Alexislilei/matter-thermostat/docs/01_requirements.md

注意：
本文中出现的一对[COMMENT]之间的文字均不需要生成代码，属于作者的注释说明内容。
例子：
[COMMENT]
这是注释
这段内容只是给开发人员的提示信息，不属于需求内容
[/COMMENT]

# ESP32-C6 Matter 温控器需求规格说明书 (v0.3)

## 1. 项目概述
本项目基于 ESP32-C6 单芯片方案实现一款标准的 Wi-Fi + Matter 温控器设备。本设备支持本地独立运行与控制，无需依赖网络即可完成基础温控功能；同时作为标准 Matter 设备，可无缝接入 Home Assistant (HAOS)、Apple Home、Google Home 等智能家居生态系统，将定时开关机、复杂联动等高级功能交由上位系统处理。

---

## 2. 硬件资源配置与引脚分配

| 硬件模块 | 型号/类型 | 连接引脚 (GPIO) | 描述 / 说明 |
| :--- | :--- | :--- | :--- |
| **主控芯片** | ESP32-C6-DEVKITC-1 | - | 板载 Wi-Fi 6 + IEEE 802.15.4 (Matter) |
| **电源/配网按键** | 轻触开关 | GPIO19 | 按下 < 1s 待机/开机；按住 > 5s 进入配对模式；按住 > 15s 恢复出厂设置 |
| **旋转编码器 A 相** | EC11 (旋钮) | GPIO21 | 命名为 `KEY_RA`；板载 10k 上拉，C 脚接地。顺时针旋转：设定温度加/菜单切换 |
| **旋转编码器 B 相** | EC11 (旋钮) | GPIO20 | 命名为 `KEY_RB`；板载 10k 上拉，C 脚接地。逆时针旋转：设定温度减/菜单切换 |
| **编码器附加按键** | EC11 (按键) | GPIO15 | 命名为 `FUNC`；一端接地，另端板载 10k 上拉。用于页面切换/确定 |
| **睡眠定时按键** | 轻触开关 | GPIO18 | 命名为 `SLEEP`；一端接地，另端板载 10k 上拉。用于启动/关闭 Sleep Timer |
| **加热器控制** | Relay / Driver | GPIO22 | 高电平：开启加热；低电平：关闭加热 |
| **温度传感器** | DHT11 | GPIO4 | 单总线数字温湿度传感器（采用去抖/滤波算法） |
| **指示灯阵列** | WS2812B RGB LED | GPIO8 | 6 颗级联 RGB LED（LED_1 至 LED_6 串联） |
| **LCD 时钟 (共用)** | SPI SCK | GPIO12 | LCD 与触摸屏共用 SCK；**无外部上拉，需配置 GPIO 内部上拉** |
| **LCD 主出 (共用)** | SPI MOSI / T_DIN | GPIO11 | LCD 数据输入与触摸屏数据输入共用 MOSI；**无外部上拉，需配置 GPIO 内部上拉** |
| **LCD 主入 (共用)** | SPI MISO / T_DO | GPIO10 | 触摸屏数据返回至 ESP32；**无外部上拉，需配置 GPIO 内部上拉** |
| **LCD 片选** | LCD CS | GPIO2 | LCD 专属片选；**无外部上拉，需配置 GPIO 内部上拉** |
| **LCD 命令/数据** | LCD DC | GPIO3 | 高电平数据，低电平命令；**无外部上拉，需配置 GPIO 内部上拉** |
| **LCD 复位** | LCD RESET | GPIO1 | 硬件控制复位；**无外部上拉，需配置 GPIO 内部上拉** |
| **LCD 背光** | LCD LED | GPIO0 | 可用 PWM 调光，或接 3.3V 常亮；**无外部上拉，需配置 GPIO 内部上拉并置高** |
| **触摸屏片选** | Touch CS | GPIO13 | 触摸芯片 XPT2046 专属片选；**无外部上拉，需配置 GPIO 内部上拉** |
| **触摸屏中断** | Touch IRQ | GPIO23 | 触摸中断线（用于唤醒/触控响应）；**无外部上拉，需配置 GPIO 内部上拉** |

> **[COMMENT] 硬件上拉说明（重要）**
> 除按键/编码器（GPIO15/18/19/20/21）外，**所有 TFT-LCD 与触摸屏相关 GPIO（GPIO0/1/2/3/10/11/12/13/23）在硬件上均未连接外部上拉电阻**。
> 因此软件初始化时必须为这些引脚配置 **GPIO 内部上拉**（`GPIO_PULLUP_ENABLE`）：
> * 控制类引脚（背光 GPIO0、复位 GPIO1、片选 GPIO2、命令/数据 GPIO3）：配置为输出模式 + 内部上拉，并置为有效电平。
> * SPI 数据引脚（SCK GPIO12、MOSI GPIO11、MISO GPIO10）与触摸引脚（CS GPIO13、IRQ GPIO23）：配置为输入模式 + 内部上拉。
> 该配置已在 `main/main.c` 的 `app_main()` 中实现。
> [/COMMENT]

---

## 3. 智能设备与网络功能 (Wi-Fi / Matter)

### 3.1 协议支持
本项目设备为标准的 Wi-Fi + Matter 温控器（Matter Thermostat）设备。
设备的温度检测值、设定温度值、加热状态及开关状态需同步暴露至 Matter 协议簇（Clusters）。

### 3.2 配网逻辑与模式 (Commissioning Modes)
* **首次上电自动配网 (First Power-on Commissioning)**：
  未绑定网络的设备在首次上电或恢复出厂设置后，自动进入 Matter 配网广播状态（广播 BLE / Wi-Fi 配网信息）。
  * **超时机制**：配网模式开启后生效时间为 15 分钟。若 15 分钟内未完成配网，设备自动关闭配网广播并退出配网模式，恢复为本地独立运行状态，以节省系统资源与保证安全。
* **手动触发配网 (Manual Pairing Trigger)**：
  在任何工作状态下，长按电源键 (GPIO19) 保持 5 秒，设备强制重置配网状态并启动一个新的 15 分钟 Matter 配网广播窗口。
* **配网状态与结果指示**：
  * **配网进行中**：LED_1 显示黄色呼吸灯，呼吸周期为 2 秒。
  * **配网成功**：LED_1 快闪两下绿色（亮 200ms / 灭 200ms），随后进入下一个工作状态（开机或待机模式）。
  * **配网失败 / 超时**：LED_1 快闪两下红色（亮 200ms / 灭 200ms），随后退出配网模式进入下一个状态。

### 3.3 配网凭证与载体 (Commissioning Credentials)
* **配网二维码 (QR Code)**：设备外壳及产品包装上须印制符合 Matter 规范的二维码（内含 Vendor ID, Product ID, Discriminator, Passcode 等信息），用于控制端 App 扫码配网。
* **手动配网码 (Manual Pairing Code)**：二维码下方须清晰印制 11 位或 21 位数字手动配网码，作为二维码破损时的备用输入方案。

### 3.4 多生态共享绑定 (Multi-Admin Feature)
设备必须完整支持 Matter 标准的 **Multi-Admin（多主控绑定）** 特性。
设备在绑定至首个生态（如 Apple Home）后，无需重置设备，即可在现有主控 App 中开启“共享/添加设备”模式，动态生成一个新的临时配网码，将其绑定至第二生态（如 Google Home、Home Assistant 等）。

### 3.5 恢复出厂与解绑 (Factory Reset & De-commissioning)
* **硬件重置**：按住 POWER (GPIO19) 按键大于 15 秒，设备触发恢复出厂设置逻辑，清空设备内存储的所有 Matter 节点凭证、Wi-Fi 网络配置及生态绑定关系。在恢复出厂操作结束后，LED_1 快闪两下白色（亮 200ms / 灭 200ms），随后 LED_2 ~ LED_6 依次逐个快闪一下（亮 200ms / 灭 200ms），最后自动重启并重新进入首次上电配网模式。
* **软件解绑**：当用户从已绑定的 Matter 控制端 App 中执行“移除设备”时，设备若接收到撤销指令，需清除对应的网络节点凭证；在成功解除绑定后，LED_1 快闪一下橙色（亮 200ms / 灭 200ms），紧接着快闪一下绿色（亮 200ms / 灭 200ms），随后进入下一个状态。当最后一个绑定节点被移除时，设备自动恢复出厂待配网状态。
* **状态复位**：重置或解绑清空凭证后，设备自动重启并进入 **首次上电配网模式**。

---

## 4. 按键与编码器检测与操作逻辑

### 4.1 通用检测算法
* 所有按键与编码器检测必须加入软件去抖动算法，消除机械与电气抖动干扰。
* 支持按键短按与长按事件检测，以及编码器的正反转相位判断（根据 `KEY_RA` 与 `KEY_RB` 的引脚电平变化次序）。

### 4.2 按键与旋转操作定义
* **电源键 POWER (GPIO19)**：
  * 按下小于 1 秒：待机 / 开机切换。
  * 按住大于 5 秒：进入配对模式（手动触发 Matter 重新配网，开启 15 分钟配网窗口）。
  * 按住大于 15 秒：恢复出厂设置（清空所有网络与配网信息，按 3.5 节规则展示灯效并重新进入配网广播模式）。
* **编码器旋转 (KEY_RA: GPIO21 / KEY_RB: GPIO20)**：
  * **主页面下**：顺时针旋转，设定温度增加 0.5℃（上限 25.0℃）；逆时针旋转，设定温度减少 0.5℃（下限 15.0℃）。
  * **Sleep Timer 设置页面下**：旋转编码器用于在睡眠时间选项之间切换选择（10 MIN -> 30 MIN -> 60 MIN -> 90 MIN，两端停住不循环）。
* **编码器附加按键 FUNC (GPIO15)**：
  * **页面切换**：按一下 FUNC 键依次循环切换页面（主页面 -> Sleep Timer 设置页面 -> 主页面）。
* **睡眠定时按键 SLEEP (GPIO18)**：
  * **定时开关**：按一下 SLEEP 键启动/关闭 Sleep Timer 倒计时（等同于点击屏上右下角的触摸按键）。
* **待机唤醒与自动超时**：
  * 在待机模式下，按下 POWER 按键小于 1 秒、短按 FUNC 按键、短按 SLEEP 按键或旋转编码器，设备立即恢复至开机模式。
  * **超时返回**：在非主页面（如 Sleep Timer 设置页）下，若持续 1 分钟（60 秒）无任何操作，系统自动保存当前设置并重置返回主页面显示。

---

## 5. UI 界面与显示需求 (ILI9341 LCD)

### 5.1 硬件与库配置
* **屏幕规格**：2.4 英寸 ILI9341 TFT LCD，分辨率 320 * 240，竖屏显示（宽 240，高 320）。
* **触控芯片**：XPT2046（通过 GPIO23 IRQ 中断进行事件响应/唤醒）。
* **图形驱动**：用 ESP-IDF 原生的 esp_lcd 组件（IDF 5.1 自带），通过 SPI 驱动 ILI9341，并使用 LVGL 作为 UI 渲染层（ESP32 官方推荐方案，性能与 TFT_eSPI 相当）。
* **LVGL 接入**：通过 `espressif/esp_lvgl_port` 组件（版本 `^1.4.0`，内部使用 LVGL 8.3）完成 esp_lcd 与 LVGL 的桥接，在 `main/idf_component.yml` 中声明依赖。
* **界面文字风格**：优先采用通用图标、图形符以及极简英文/英文缩写，兼顾直观性与系统稳定性。

### 5.2 页面结构与布局定义

```
+---------------------------------------------+  <-- Y = 0
| Fri, Mar 11  19:45                  (Wi-Fi) |  1. Top Bar (日期/时间/Wi-Fi, H: 26px)
+---------------------------------------------+
|                                             |
|                   ● (20°)                   |
|              .-------------..               |  2. Central Arc & Temp Area (Y: 28 ~ 250)
|            /     .--------.    \            |     - 270° 刻度环 (135° ~ 45°)
|    ●(17.5°)|   /   23°    \   |● (22.5°)   |     - 蓝色实心进度圆弧 (当前温度)
|            |  |  (当前室温) |  |   [22.5°]  |     - 黄色刻度线与外侧目标温度标签
|            \   \  ROOM    /   /   (目标指针)|     - 内部深色同心圆表盘
|    15° ●    `-------------`    ● 25°        |     - 表盘正中心大字整数室温 (如 23°)
|                                             |     - 底侧 15° 与 25° 极值标注
+---------------------------------------------+
|  +---------------+       +---------------+  |  3. Bottom Area (Y: 256 ~ 312)
|  |    HEATER     |       |  SLEEP TIMER  |  |     - 左侧: 加热状态卡片 (HEAT/OFF)
|  |  HEAT / OFF   |       |  OFF / 28:30  |  |     - 右侧: Sleep Timer 定时按钮
|  +---------------+       +---------------+  |
+---------------------------------------------+  <-- Y = 320
```

#### **页面 1：主页面 (Main Page)**
1. **第一行：顶部状态栏 (Top Bar)**
   * **布局**：单行紧凑排列。
   * **左侧**：显示当前日期与时间（缩写星期与月份，24 小时制，例如：`Fri, Mar 11  19:45`）。时间通过 SNTP 获取 UTC 并转换为 **澳大利亚东部标准时间（AEST/AEDT，自动夏令时）**。
   * **右侧**：显示 Wi-Fi 状态图标（`LV_SYMBOL_WIFI`）。已连接常亮；未连接时以 0.5s 周期闪烁提示。
2. **第二行：中央温度控制与显示区 (Central Arc & Temp Display)**
   * **温度范围**：**15.0°C 至 25.0°C**（共 21 个 0.5°C 档位）。
   * **中央当前温度**：显示在圆环正中央深色同心表盘中，大字体（48 号字），仅显示**整数**（例如：`23°`），下方配 `ROOM` 标签。
   * **当前温度蓝色圆弧与目标温度圆弧**：
     * 从 15°C 起始刻度（135°）开始顺时针绘制亮蓝色圆弧（`#00B4FF`），延伸至当前实测温度对应的角度。
     * **圆环尺寸**：外侧温度指示与调节圆弧半径设计为紧凑尺寸（外半径 84px，尺寸 168×168），与内部中央表盘（半径 63px，尺寸 126×126）之间保持约 11px 的清晰间隙，不与内圆接触，两侧留出充足屏幕边距。
   * **外圈刻度点与极值**：外圈半径 84px 处分布 5 个分度圆点（15.0°C, 17.5°C, 20.0°C, 22.5°C, 25.0°C），底部两侧分别标注 `15°` 与 `25°`。
   * **目标温度指示与显示**：
     * **黄色刻度线**：在圆环外圈以黄色滑块（`#FFD700`）指示当前设定的目标温度位置。
     * **目标温度数值**：在黄色刻度线外侧水平显示目标温度数值，支持 1 位小数精度（例如：`22.5°`），黄色文字。当设定为 20.0°C（270° 正上方）时，读数位置确保完全在顶部白底状态栏（Y=0~26）下方并留有安全间距，不侵入顶部白底。
   * **目标温度调节逻辑**：
     * **触摸调节**：支持通过触摸屏滑动黄色刻度线调节（自动吸附为 0.5°C 步长）。
     * **编码器调节**：支持旋转编码器输入。顺时针增加 0.5°C，逆时针减少 0.5°C，范围限制在 15.0°C ~ 25.0°C。
3. **第三行：底部状态与操作栏 (Bottom Area)**
   * **左侧 (加热状态)**：卡片式按钮显示 `HEATER`，状态显示 `HEAT`（加热中，红色高亮）或 `OFF`（未加热，灰白色）。
   * **右侧 (Sleep Timer 按钮)**：卡片式按钮显示 `SLEEP TIMER`，下半部分显示 `OFF` 或倒计时时间（`mm:ss` 格式，绿色高亮）。触摸点击该按钮可开启/关闭倒计时。倒计时结束后自动切换至待机模式。

#### **页面 2：定时睡眠设置页 (Sleep Timer Page)**
* **页面标题**：顶部显示 `SLEEP TIMER SETTING`，标题栏为蓝底黑字。标题栏紧贴顶部日期/时间栏下方（y=30），蓝色底不遮挡日期与时间。
* **选项列表**：提供 4 个选项，从上到下顺序为 `10 MIN` / `30 MIN` / `60 MIN` / `90 MIN`（已移除 `OFF` 选项）。
* **默认值**：第一次开机默认值为 `30 MIN`。
* **记忆功能**：改动后记忆该设定值，下次上电时从 NVS 读取记忆的设定值（命名空间 `sleep_timer`，键 `setting`）。
* **显示方式**：选中项始终显示在屏幕中间偏下位置（较屏幕正中整体下移 22px），选中项文本外有一个框，颜色为正常显示的反转（白底黑字）；未选中项为黑底白字（黑色背景 + 白色文字）。
* **编码器操作**：
  * 顺时针旋转编码器一格，整个选项列表向上移动一个位次（选中项向后移动），到最后一个选项（`90 MIN`）就停住，不做周期移动。
  * 逆时针旋转则反之，到第一个选项（`10 MIN`）停住。
  * 若向上移动后最上面的空间不够（不能阻挡页面标题），则最上面一个选项不显示；反之（超出屏幕底部）亦然。选中 `10 MIN` 时 `90 MIN` 选项仍会显示（其框底恰好贴屏幕底边 320）。
* **触发方式**：实体 FUNC 按键仅将主页面切换到本设置页（不启动倒计时）；仅屏上右下角的触摸按键触发 sleeper（睡眠定时）启动。
* **倒计时逻辑**：触摸按键确认选择后开始倒计时，页面回到主页面，倒计时结束后设备自动切入待机模式（软关机），GPIO22 关闭加热。

#### **页面 3：待机页 (Standby Page)**
* **页面布局与要素**：
  * **第一行（顶部）**：保持显示顶部状态栏（白底黑字，左侧显示日期/时间，右侧显示 Wi-Fi 图标）。
  * **第二行（中央偏上）**：以超大号字（与主页面一致，48 号字白色）显示实测当前室温（例如：`20°`）。
  * **第三行（中央偏下）**：以大号字（32 号字白色）显示 `STANDBY` 状态指示。
  * **控件隐藏**：待机模式下隐藏主页的温度调节圆弧、表盘刻度与底部加热/定时操作按钮，保持待机界面极简且清晰。

### 5.3 触摸屏校准需求 (Touch Calibration)

> **[COMMENT] 背景说明**
> 电阻式触摸屏（XPT2046）的原始 ADC 值范围与方向因硬件个体差异而不同，且屏幕坐标与 ADC 通道之间可能存在轴交换（swap_xy）与镜像（invert_x / invert_y）。为保证触摸坐标映射准确（例如 Timer 按钮点击位置正确），需在首次使用时进行一次校准，并将校准参数持久化存储，避免每次上电重复校准。
> [/COMMENT]

1. **首次开机自动校准 (First Power-on Calibration)**：
   * 设备**首次上电**（或校准参数缺失/无效）时，自动进入触摸校准流程，在 LCD 上显示校准页面。
   * 校准页面标题 `TOUCH CALIBRATION` 位于屏幕**中间偏上**位置（在中间提示文字上方，避免重叠）。
   * 校准页面依次提示用户点击屏幕 **4 个角点**：左上 (TL) → 右上 (TR) → 左下 (BL) → 右下 (BR)。
   * 每个角点显示一个圆形目标标记，用户按下后采样该点的原始 ADC 值，松开后进入下一个角点。
   * 4 个角点全部采样完成后，根据角点原始值自动计算校准参数：
     * 自动判定 X/Y 轴是否需要交换（`swap_xy`）。
     * 自动判定 X/Y 轴是否需要镜像（`invert_x` / `invert_y`）。
     * 计算各轴的最小/最大值（`x_min` / `x_max` / `y_min` / `y_max`），用于将原始 ADC 值线性映射为屏幕像素坐标（240×320）。
   * 若某角点采样无效（如轴范围过小 < 50），判定为无效采样，重新等待该角点输入。
2. **校准参数持久化存储 (Persistence)**：
   * 校准完成后，将校准参数（`touch_calibration_t`）与"已校准"标记写入 **NVS**（命名空间 `touch_calib`，键 `calib` 与 `calibrated`）。
   * 校准参数在设备重启后仍然保留。
3. **后续上电跳过校准 (Skip on Subsequent Power-on)**：
   * 每次上电时检查 NVS 中的"已校准"标记：
     * 若标记存在（已校准）：直接加载校准参数，**跳过**校准流程，进入正常主界面。
     * 若标记不存在（未校准）：执行首次校准流程。
4. **校准期间交互隔离**：
   * 校准流程进行期间，触摸轮询任务（`touch_poll_task`）暂停处理 Timer 按钮等正常触摸交互，避免校准触摸被误判为按钮点击。
   * 校准页面激活期间，正常 UI 渲染（`ui_render`）暂停更新，避免覆盖校准页面。
   * 校准页面激活期间，隐藏所有非校准相关内容（日期时间、Wi-Fi 符号、室温、设定温度、加热状态、Timer 按钮、待机文字、Sleep Timer 标题与选项等），仅显示校准页面内容；校准结束后恢复普通 UI。

---

## 6. 指示灯阵列与灯效设计

### 6.1 硬件阵列分工与映射
* **LED_1**：温控器状态/配网指示灯。
* **LED_2 ~ LED_6**：当前温度与目标设定温度指示灯。
  * **LED_2**：<= 17 ℃
  * **LED_3**：18 ℃
  * **LED_4**：19 ℃
  * **LED_5**：20 ℃
  * **LED_6**：>= 21 ℃

### 6.2 灯效展示规则
1. **快闪定义 (Fast Blink)**
   * 文中所述的 “快闪” 均指：亮 200ms，灭 200ms 的闪烁周期。
2. **上电自检 (POST)**
   * 上电后，LED_1 至 LED_6 依次点亮 100ms 白色后熄灭，随后进入待机模式（若未配网则进入配网模式）。
3. **配网及网络状态灯效**
   * **配网进行中**：LED_1 显示黄色呼吸灯，呼吸周期为 2 秒。
   * **配网成功**：LED_1 快闪两下绿色（亮 200ms / 灭 200ms），再进入下一个状态（开机/待机）。
   * **配网失败 / 超时**：LED_1 快闪两下红色（亮 200ms / 灭 200ms），再进入下一个状态。
   * **解除绑定**：成功解绑后，LED_1 快闪一下橙色，再快闪一下绿色（各亮 200ms / 灭 200ms）。
   * **恢复出厂结束**：恢复出厂结束后，LED_1 快闪两下白色，随后 LED_2 ~ LED_6 依次逐个快闪一下（各亮 200ms / 灭 200ms）。
4. **开机模式灯效**
   * **所有LED灯亮度设定位50%**
   * **LED_1（加热/状态指示）**：
     * **加热中 (GPIO22 = HIGH)**：循环展示灯效——200ms 橙色 -> 200ms 红色 -> 200ms 紫色 -> 循环。
     * **未加热 (GPIO22 = LOW)**：常亮绿色。
   * **LED_2 ~ LED_6（温度指示）**：
     * 小于当前实测温度的指示灯：常亮绿色。
     * 大于当前实测温度且非设定温度的指示灯：熄灭。
     * 设定温度对应的指示灯：显示紫色。
     [COMMENT]
     这里的
       * 若实测温度 < 设定温度：显示紫色。
       * 若实测温度 >= 设定温度：交替显示绿色和紫色，各切换保持 1 秒。
       
     [/COMMENT]
    
5. **待机模式灯效**
   * **待机定义**：软待机（软关机）。内部主控、Matter 协议、Wi-Fi 及温度采集控制逻辑均正常运行，GPIO22 停止加热，LED_2 ~ LED_6 熄灭。
   * **LED_1（待机温度呼吸灯）**：根据当前 DHT11 实测温度，以 2 秒为周期进行呼吸显示，颜色映射关系如下：
     * <= 17 ℃：蓝色呼吸灯
     * 18 ℃：青色呼吸灯
     * 19 ℃：绿色呼吸灯
     * 20 ℃：黄色呼吸灯
     * 21 ℃：橙色呼吸灯
     * 22 ℃：红色呼吸灯
     * >= 23 ℃：紫色呼吸灯

---

## 7. 温控与采样算法

### 7.1 温度数据去抖与滤波
DHT11 数据采集需采用数字滤波/去抖动算法（如滑动平均滤波或中值滤波），避免突发噪声引发系统频繁误判及屏幕数字频繁跳动。

### 7.2 迟滞温控逻辑 (Hysteresis Control)
* **设定温度限制**：设定温度限制在 15.0 ℃ 至 25.0 ℃（步长 0.5 ℃）。
* **动态阈值调整**：为防止加热开关在临界点频繁启停，设置 ±0.5 ℃ 的控制滞后区间。
* **升温过程**：当加热器处于开启状态时，只有当实测温度上升至 `设定温度 + 0.5 ℃` 时，才关闭加热器 (GPIO22 = LOW)。
* **降温过程**：当加热器处于关闭状态时，只有当实测温度下降至 `设定温度 - 0.5 ℃` 时，才重新开启加热器 (GPIO22 = HIGH)。
