Alexislilei/matter-thermostat/docs/others/TFT LCD 2.8 inch ILI9341 touch.step

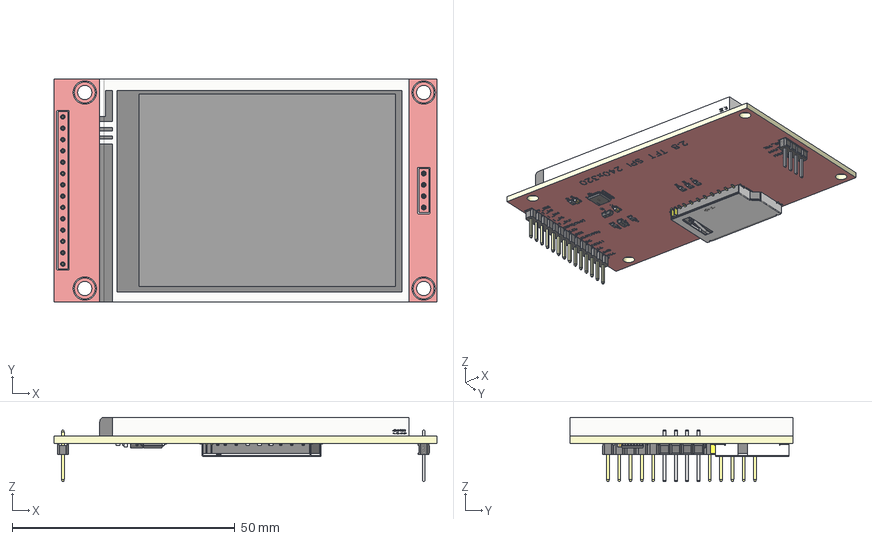
[picture p1: CAD file, 2026-07-20, last stored version]
docs/others/TFT LCD 2.8 inch ILI9341 touch.step
86.0 x 50.0 x 14.5 mm
Board~s9RP
TopSilkscreen~s9RP
BottomSilkscreen~s9RP
HDR-TH_4P-P2.54-V-M~HDR-TH_4P-P2.54-M-LI-1X4P~s9RP
R0603~R0603~s9RP x 6
C0603~C0603_L1.6-W0.8-H0.8~s9RP x 2
CONN-TH_PZ254V-11-14P~CONN-TH_PZ254V-11-14P~s9RP
SD-CARD-SMD_SD-CARD-11P~SD-CARD-SMD_SD-CARD-11P~s9RP
TSSOP-16_L5.0-W4.4-P0.65-LS6.4-BL~TSSOP-16_L5.0-W4.4-H1.0-LS6.4-P0.65 ~s9RP
SOT-23-3_L2.9-W1.3-P1.90-LS2.4-BR~SOT-23-3P_L2.9-W1.3-H1.0-LS2.4-P0.9 5~s9RP x 2
