Alexislilei/matter-thermostat/docs/tft-lcd-2-8-inch-ili9341-touch-320x240-1.snapshot.22/TFT LCD 2.8 inch ILI9341.stl

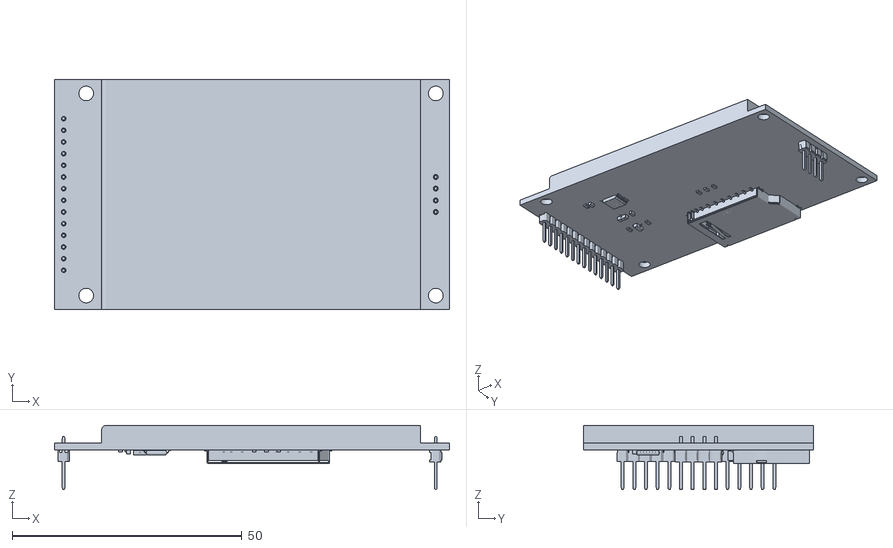
[picture p2: CAD file, 2026-07-19, last stored version]
docs/tft-lcd-2-8-inch-ili9341-touch-320x240-1.snapshot.22/TFT LCD 2.8 inch ILI9341.stl
86.0 x 50.0 x 14.0
