Alexislilei/matter-thermostat/docs/thermostat-hardware/thermostat-hardware.kicad_sch

## KiCad design docs/thermostat-hardware/thermostat-hardware.kicad_sch (2026-07-20, an earlier design)

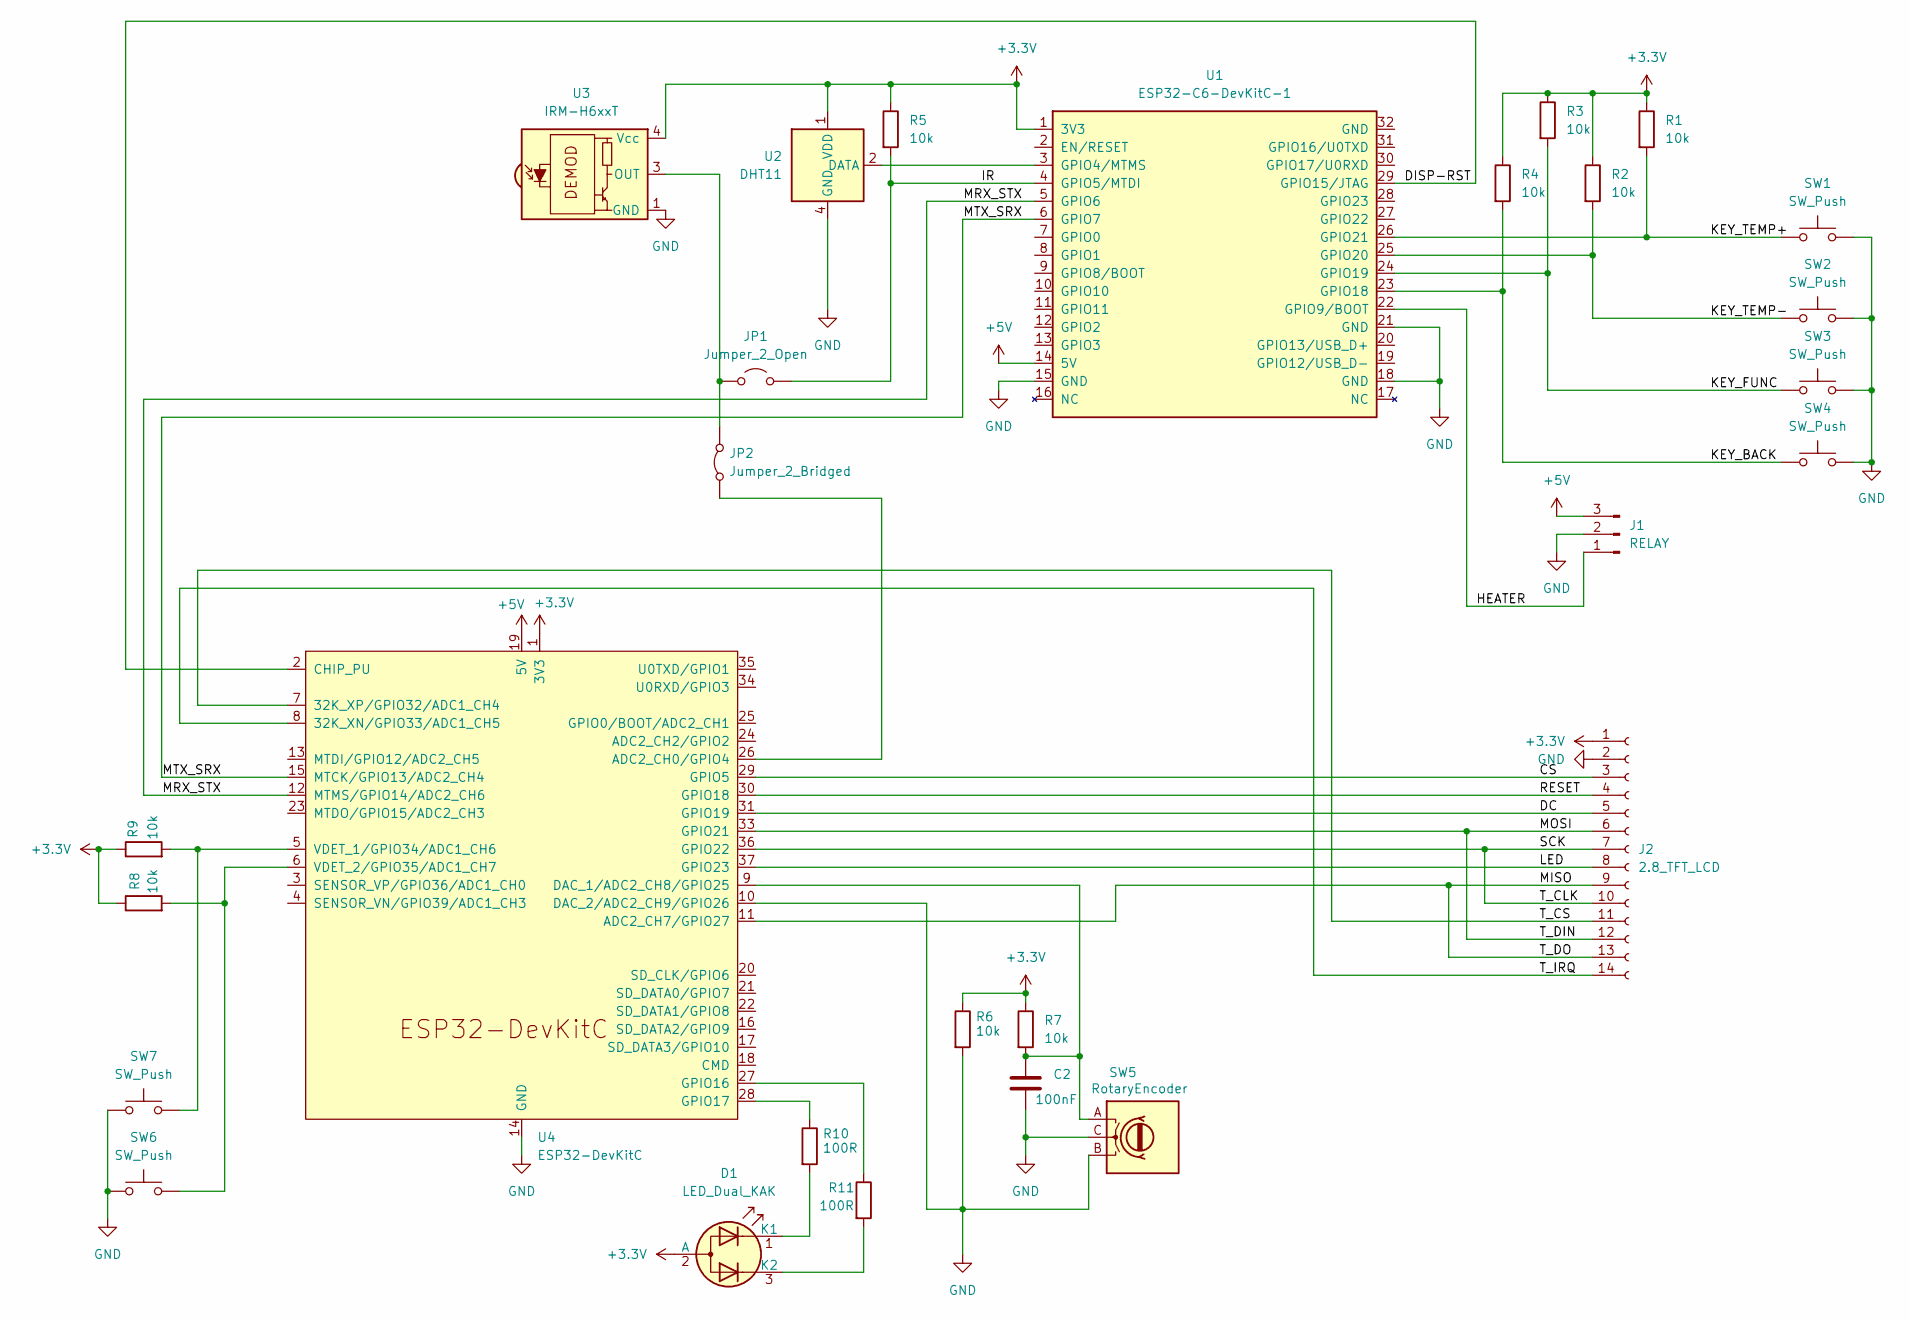
[picture p3: schematic thermostat-hardware.kicad_sch]

Parts:
C2: 100nF; C_Rect_L7.0mm_W2.0mm_P5.00mm
D1: LED_Dual_KAK
J1: RELAY
J2: 2.8_TFT_LCD
JP1: Jumper_2_Open
JP2: Jumper_2_Bridged
R1, R2, R3, R4, R5, R6, R7, R8, R9: 10k; R_Axial_DIN0207_L6.3mm_D2.5mm_P7.62mm_Horizontal
R10, R11: 100R; R_Axial_DIN0207_L6.3mm_D2.5mm_P7.62mm_Horizontal
SW1, SW2, SW3, SW4, SW6, SW7: SW_Push; SW_PUSH_6mm
SW5: RotaryEncoder
U1: ESP32-C6-DevKitC-1
U2: DHT11; Aosong_DHT11_5.5x12.0_P2.54mm
U3: IRM-H6xxT; Everlight_IRM-H6xxT
U4: ESP32-DevKitC

Connections:
+3.3V: D1.2 (A), J2.1, R1.1, R2.1, R3.1, R4.1, R5.1, R6.1, R7.1, R8.1, R9.1, U1.1 (3V3), U2.1 (VDD), U3.4 (Vcc), U4.1 (3V3)
+5V: J1.3, U1.14 (5V), U4.19 (5V)
CS: J2.3, U4.29 (GPIO5)
DC: J2.5, U4.31 (GPIO19)
DISP-RST: U1.29 (GPIO15/JTAG), U4.2 (CHIP_PU)
GND: C2.2, J1.2, J2.2, R6.2, SW1.2, SW2.2, SW3.2, SW4.2, SW5.B, SW5.C, SW6.1, SW7.1, U1.15 (GND), U1.18 (GND), U1.21 (GND), U2.4 (GND), U3.1 (GND), U3.2 (GND), U4.10 (DAC_2/ADC2_CH9/GPIO26), U4.14 (GND), U4.32 (GND), U4.38 (GND)
HEATER: J1.1, U1.22 (GPIO9/BOOT)
IR: JP1.2 (B), R5.2, U1.4 (GPIO5/MTDI)
KEY_BACK: R4.2, SW4.1, U1.23 (GPIO18)
KEY_FUNC: R3.2, SW3.1, U1.24 (GPIO19)
KEY_TEMP+: R1.2, SW1.1, U1.26 (GPIO21)
KEY_TEMP-: R2.2, SW2.1, U1.25 (GPIO20)
LED: J2.8, U4.37 (GPIO23)
MISO: J2.9, J2.13, U4.11 (ADC2_CH7/GPIO27)
MOSI: J2.6, J2.12, U4.33 (GPIO21)
MRX_STX: U1.5 (GPIO6), U4.12 (MTMS/GPIO14/ADC2_CH6)
MTX_SRX: U1.6 (GPIO7), U4.15 (MTCK/GPIO13/ADC2_CH4)
unnamed: C2.1, R7.2, SW5.A, U4.9 (DAC_1/ADC2_CH8/GPIO25)
unnamed: D1.1 (K1), R10.2
unnamed: D1.3 (K2), R11.2
unnamed: JP1.1 (A), JP2.2 (B), U3.3 (OUT)
unnamed: JP2.1 (A), U4.26 (ADC2_CH0/GPIO4)
unnamed: R8.2, SW6.2, U4.6 (VDET_2/GPIO35/ADC1_CH7)
unnamed: R9.2, SW7.2, U4.5 (VDET_1/GPIO34/ADC1_CH6)
unnamed: R10.1, U4.28 (GPIO17)
unnamed: R11.1, U4.27 (GPIO16)
unnamed: U1.3 (GPIO4/MTMS), U2.2 (DATA)
RESET: J2.4, U4.30 (GPIO18)
SCK: J2.7, J2.10, U4.36 (GPIO22)
T_CS: J2.11, U4.7 (32K_XP/GPIO32/ADC1_CH4)
T_IRQ: J2.14, U4.8 (32K_XN/GPIO33/ADC1_CH5)
