Alexislilei/matter-thermostat/(commit log)

2026-07-16 feat: 增加需求文档
2026-07-16 feat：增加架构设计文档
2026-07-19 feat：增加原理图
    [TFT LCD 2.8 inch ILI9341.stl, thermostat-hardware.kicad_pcb, thermostat-hardware.kicad_sch]
2026-07-20 feat：增加ESP32-C6的管脚定义
    [TFT LCD 2.8 inch ILI9341 touch.step, TFT LCD 2.8 inch ILI9341.stl, thermostat-hardware.kicad_sch]
2026-07-22 feat:为AI agent roo code增加roorules
2026-07-26 feat:需求大修改，将方案简化为单芯片简单显示的最基本功能matter温控器
    [TFT LCD 2.8 inch ILI9341 touch.step, thermostat-hardware.kicad_pcb, thermostat-hardware.kicad_sch]
2026-07-26 feat:需求大改动后的相应文件的修改
2026-07-26 fix:第一次调试，初步跑通
2026-07-29 fix:添加串口打印配网信息，配网调试，homekit温度调节功能显示
    [partitions.csv]
2026-08-09 feat-对配网功能的具体操作要求细化，使得操作更逻辑严谨
2026-08-09 feat:需求变更-采用旋钮调节温度
2026-08-10 feat：修改配网和恢复出厂的触发方式
2026-08-12 feat：增加2.4寸液晶显示器，点亮验证验证
2026-08-12 feat:增大显示得字体，实现wifi图标
2026-08-12 feat：实现了sleep timer设置页面和倒计时显示，fix了旋转编码器的问题
2026-08-14 fix：针对crash问题做了设计，结论是硬件RF干扰和供电不足-存疑
    [partitions.csv]
2026-08-15 feat:需求明确：时间为AEST，自动夏令时+fix bugs
2026-08-16 fix&feat：将触摸屏驱动补上，并调试完毕；增加触摸屏校正功能
2026-08-16 feat：需求变更，改变sleep timer启动的触发方式，修改sleep timer设置菜单
2026-08-16 feat:将主页UI改为lvgl官方温控器demo风格+旋钮
2026-08-27 fix：解决触摸屏下部按压不响应问题
